sap1119/BTSecureLocker/(commit log)

2026-08-31 Initial commit: SecureLocker firmware, docs, and repo standards
    Bluetooth-Based Secure Locker with Access Logging — an LPC2148 (ARM7TDMI-S)
    two-factor locker firmware: Bluetooth password (HC-05 over UART1) + keypad
    password, EEPROM-stored credentials, RTC-timestamped audit log, tamper and
    lockout handling.
    - firmware/: 12 C modules + headers, Keil project (majorproject12.uvproj),
    prebuilt majorproject12.hex, vendored LPC214x.h for Keil-free builds
    - docs/: beginner getting-started, architecture, register-level reference
    (9 pages), firmware behaviour flows (5 pages), hardware + testing
    - CI: .github/workflows/build.yml compile-checks every TU with
    arm-none-eabi-gcc (C89, -Wall -Wextr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
2026-08-31 docs: rotate and resize board photo; rewrite README with structured layout
2026-08-31 docs: draw full-project flowcharts; mark hardware-tested status (RTC + future excepted)
2026-08-31 docs: add ready-to-print submission notes (SUBMISSION_NOTES.md)
